SnorbWorks/ender3-pi/PLAN.md

# Ender 3 + Pi — Plan

> **2026-11-09:** the web UI (Ender Studio, `studio/`) moved to its own repo and is now
> **SnorbStudio**, https://github.com/SnorbWorks/snorbstudio (the Design tab is now **SnorbCAD**).
> Paths like `studio/...` below refer to that repo (minus the `studio/` prefix).

Started 2026-10-27. A Raspberry Pi 4 (1 GB, `raspberrypi-1`, 10.0.0.139) runs the
printer over USB with Klipper, and a web UI of our own controls it over Wi-Fi.

## What we have

| | |
|---|---|
| Printer | Reports "Ender-3 E", Creality Marlin 2.0.8.2 (Sep 2022) |
| Link | CH340 USB serial → `/dev/ttyUSB0` on the Pi, 115200 baud |
| Probe | ABL probe (CR Touch style), offset X-43 Y-10, 4×4 mesh |
| Extruder | 93 steps/mm (Creality metal extruder, as on the Neo line) |
| Bed | Mesh spread ≈ 0.46 mm (-0.19 → +0.27): low front left, high at the back |
| Stock tuning | Accel 500, jerk 6, hotend PID 12.53/0.68/47.63, bed PID 198.96/38.80/680.25 |
| Backup | `backup/marlin-M503-2026-10-27.txt`, `backup/marlin-M115-2026-10-27.txt` |

| Mainboard | Creality **V4.2.2**, chip **STM32F103 RCT6** (genuine ST; photo 2026-10-27) |

Klipper build for it (`firmware/klipper-20261027.config`): STM32F103, 28 KiB
bootloader (0x8007000), 8 MHz crystal, serial on USART1 (PA10/PA9) at 250000.

## The firmware answer

Klipper splits the work: the Pi does the thinking (motion planning, macros,
input shaping) and the printer's board only runs a small Klipper program that
moves motors and reads sensors. So **yes, the printer's Marlin gets replaced**
with Klipper's MCU firmware, flashed from the SD card. It's reversible: the
stock Creality `.bin` can be flashed back the same way, and the backup above
has its settings.

## Phases

### 1. Ground work (the Pi)
- Update the OS, set a fixed address (DHCP reservation or `raspberrypi-1.local`).
- Install Klipper + Moonraker (Moonraker is the API our UI talks to).
- Install **Mainsail** too, as a known-good reference/fallback while our UI grows.
- Keep it light for 1 GB: no slicing or building on the Pi; the UI is built on
  the Mac and served as static files by nginx.

### 2. Klipper on the printer
- Identify the board/chip (above), build the matching Klipper firmware.
- Download and keep Creality's stock firmware for this model (way back).
- Flash from the SD card; confirm Klipper connects over `/dev/serial/by-id/…`.
- Write `printer.cfg` from Klipper's sample for the board, with the probe
  offset, `safe_z_home`, bed mesh, runout sensor and thermal protection.

### 3. Calibrate (first prints)
Order matters; each builds on the last.
1. Endstops, motor directions, probe accuracy (`PROBE_ACCURACY`), Z offset.
2. PID for hotend and bed (`PID_CALIBRATE`).
3. Extruder rotation distance (100 mm extrude test).
4. Bed mesh (e.g. 7×7, adaptive meshing per print).
5. Flow / extrusion multiplier, first layer.
6. Pressure advance (tower).
7. **Input shaper** (needs an ADXL345 accelerometer, ~$10): the biggest
   quality-at-speed jump Klipper offers; then raise accel/speed.
8. Retraction, max volumetric flow, skew correction.

### 4. Our web UI (the big one)
Runs in any browser on the network; talks to Moonraker's WebSocket API.
- **Dashboard:** state, temps with graph, progress/ETA, live toolhead position,
  current layer, fan/speed/flow sliders, pause/resume/cancel, emergency stop.
- **Files:** upload G-code (drag & drop), thumbnails, metadata (time, filament),
  print history, start/queue.
- **Modify prints:** G-code viewer with layer preview; edits applied on the Pi
  before printing: pause at layer (filament swap), temperature/speed changes
  at a height, swap start/end G-code, cancel single objects mid-print
  (Klipper `exclude_object`).
- **Control:** jog/home, bed mesh view (3D heatmap), macros as buttons,
  calibration wizards (PID, pressure advance, input shaper) with guided steps.
- **Monitoring:** webcam, timelapse, notifications when a print ends or fails.
- Later: slicing from STL (a slicer CLI, likely on the Mac/another machine,
  not the 1 GB Pi).

### 5. Hardware upgrades (pick as we go)
By payoff for print quality:
1. ADXL345 accelerometer (input shaping) — needed in phase 3.
2. USB webcam (monitoring, timelapse).
3. PEI spring-steel sheet (adhesion, easy removal) if not fitted.
4. Belt tension check, eccentric nuts, silicone bed spacers (holds level).
5. Later: better hotend / direct-drive, part-cooling fan duct.

## Safety rules
- Never open the USB serial port mid-print (it resets the board).
- Keep Klipper's heater checks on; watch the first prints in person.
- Flashing is done by the owner with the printer powered and attended.

## Status
- 2026-10-27 phase 1 done: OS updated; Klipper v0.13.0-818, Moonraker v0.11.0,
  Mainsail v2.19.0 behind nginx at http://raspberrypi-1.local. `printer.cfg` is a
  placeholder (no [mcu]) until the board is flashed.
- Klipper firmware built: `firmware/klipper-20261027.bin`.

- 2026-10-28/29: board flashed, Klipper running the original Ender 3 (blue 12864
  screen). Probe lowered, Z coupler tightened (fixed the height loss), PID + bed
  mesh saved, z_offset 2.950 from first-layer prints. z_guard extra added.
  Ender Studio (our web UI) on port 80, Mainsail on 8080.
- 2026-11-05: filament presets (PLA, PLA+, Silk, PETG, TPU, ABS/ASA) with
  per-filament first-layer squish; temperature tower follows the filament.
  Repo public at https://github.com/SnorbWorks/ender3-pi. Ender Studio now
  updates itself from it (studio/server/updater.py + studio/deploy/install.sh).
  None of the 2026-11-05 work is on the Pi yet (it was off).

- 2026-11-05 evening: Pi switched to the git install (~/ender3-pi, ~/studio ->
  checkout, old copy kept as ~/studio.old-20261105-192607). New macros load
  with no config errors. Two pushed updates installed end to end via push.sh
  (84aaecf, 0f67a59). Printer USB was unplugged/off at the time, so nothing
  printer-side (squish macros in a real print) is tested yet.

## Design tab (Ortho CAD), started 2026-11-09
The owner's spec: `studio/design/SPEC.md`. CAD by drawing in orthographic drafting
views (third-angle), one shared feature list, STL straight to Prepare.

- Source: `studio/design/src` (TypeScript). Build on the Mac with
  `cd studio/design && npm install && npm test` (`npm test` builds too); the output in
  `studio/web/design/` IS committed (the Pi never builds). `replicad_single.wasm` (22 MB,
  OpenCASCADE) only changes when replicad is upgraded.
- All geometry runs in the browser (a worker): the Pi only serves files.
  The tab loads on first visit, so Prepare etc. never pay for the engine.
- Model: stock block + ordered features {rect|circle, view drawn in, centre/size in
  that view's u/v, d0 (face) / d1 (end) as depth toward that view's viewer, add|cut,
  through}. Hidden lines come from OpenCASCADE HLR per view; a visible line wins over a
  hidden one in the same place (`subtractCovered`), duplicates dropped (`dedupe`).
- Choices the owner made: Design tab next to Prepare; Mac mouse/trackpad only; gear tool
  takes module or DP, 14.5/20/25 deg, bore none/round/D-shaft + set screw; checkpoint
  after build-order steps 1-3.
- Projects autosave in the browser (localStorage) and Save/Open (⌘S) keeps them on the Pi:
  `/studio-api/designs/<name>.json` -> `~/printer_data/design/`.
- 2026-11-09 owner feedback round 1 (done): tools in a left toolbox with tool cursors;
  multi-select (shift-click, drag a box); the bar above follows the selection (align
  left/centre/right/top/middle/bottom to each other or to the part, distribute, delete);
  alignment uses the active view (last clicked, label highlighted); ghost views are small
  rounded boxes and empty rows/columns shrink; Option-click a rectangle side,
  Option-Shift-click the side next to it = their corner, with its own radius
  (Feature.corners). Rounds 2-3: body selectable, bigger views, zoom tool, panel splitter.
- Steps 4-7 + the rest of the spec's tools (done 2026-11-09): polygon (P), line/outline (L),
  gear (G: spur/helical/ring/rack, module or DP, 14.5/20/25, backlash, bore none/round/D,
  set screw, hub; a new gear offers to mesh with one already there), text (T, DejaVu fonts),
  hidden-line toggle (H: new shapes go on the far face as pockets, `Feature.far`), edge
  tool (E: pick edges in any view, fillet/chamfer = a 'fillet' feature that remembers each
  edge by a point on it), dimensions (D; double-click the number to type a size), pattern
  (row/circle) and mirror per shape in the panel, body on/off (`stock.off`, for loose
  gears), a features list. Gear flanks are 2 least-squares Béziers each (within 0.5% of
  the module of the true involute) to keep edge counts and HLR time down.
- Round 4 (2026-11-09): fillets follow their edges (`FilletSpec.refs`: the shape whose box
  the edge sits on + where in it, re-found after every build; an edge that's really gone
  shows red with Re-pick); views grow to fit their dimensions (layout margins); projection
  lines for the selection + hidden lines toggle in a Views tab; Send to Library (STL + the
  design saved under the same name); Library "Send to Design" / Open… opens that saved
  design, else the STL as the body (`Project.base`, sewn into a solid in the worker, max
  60k triangles; ~5 s a change on the Pi tray STL since curves are facets).
  `studio/design/tools/pi5_case_design.mjs` turns models/pi5_case.py into Design projects
  (models/pi5_case_*.design.json, uploaded to the Pi as designs pi5_case_tray/_lid).
- Known limits: helical gears take a few seconds to build; an STL body's own walls can't
  be resized (no shapes in an STL); Studio's New still uses a browser confirm().

Build order (spec): 1-7 all DONE. Still open from the spec: print-orientation override in
the tool (Prepare's auto-orient is used now), shell (spec says later).

## Next
1. Owner: connect/switch on the printer, fit the Capricorn tube, re-check the
   Z offset, PETG temperature tower, then a first PETG print (tune squish
   live, "Save for this filament").
2. Watch the first real PRINT_START with MATERIAL=petg: offset applied,
   _STUDIO_FILAMENT set, PRINT_END/cancel clears it.

## Publishing updates
Commit on the Mac, then `sh studio/deploy/push.sh`: pushes to GitHub and, if
the Pi is on, asks it to install now. Otherwise the Pi checks once per
start-up (after the services have stayed up for a minute) and installs when idle (not printing, heaters off,
not slicing). If Ender Studio or Klipper doesn't come back after an update,
install.sh rolls back to the previous commit and won't retry that commit on
its own. Firmware (`firmware/`) and `config/printer.cfg` are NOT pushed by
updates: printer.cfg on the Pi is the live copy (SAVE_CONFIG writes it).
