SnorbWorks/ender3-pi/models/pi5_tray_and_gears.stl

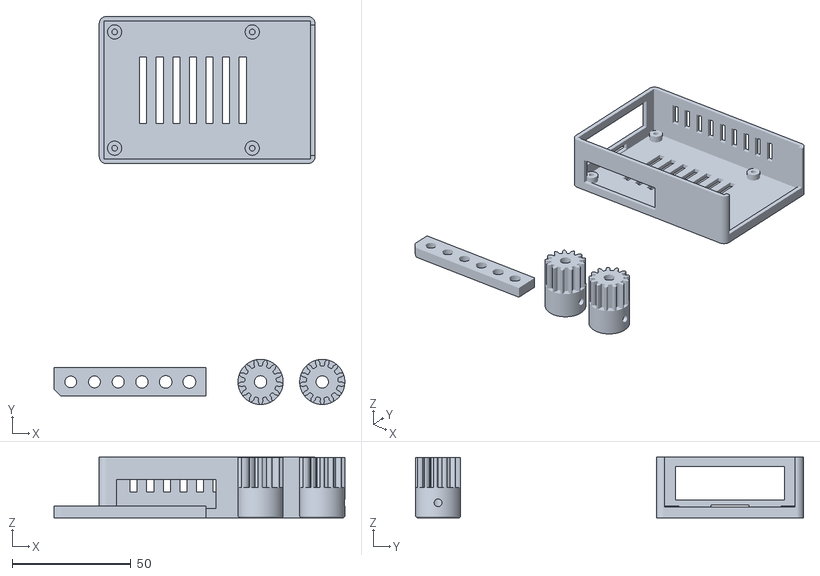
[picture p1: CAD file, 2026-11-06, last stored version]
models/pi5_tray_and_gears.stl
122.5 x 163.5 x 25.6
