SnorbWorks/ender3-pi/models/bore_test.stl

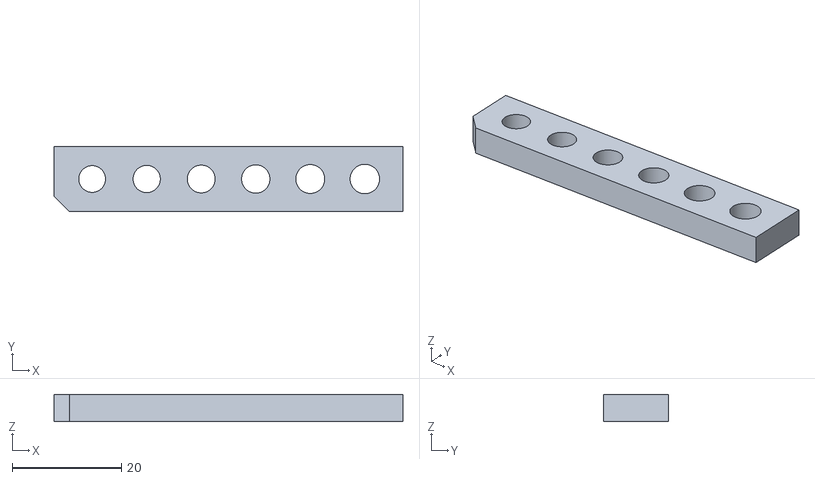
[picture p2: CAD file, 2026-11-06, last stored version]
models/bore_test.stl
64.0 x 12.0 x 5.00
