SnorbWorks/ender3-pi/models/pinion13_20dp_pa14.5.stl

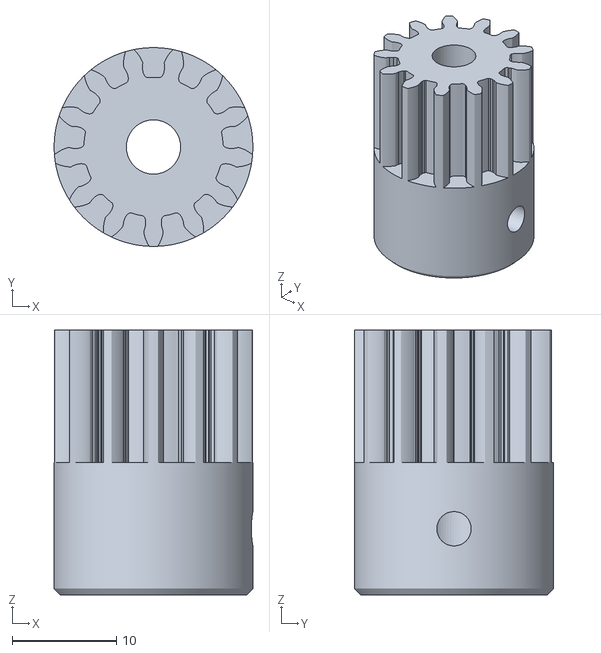
[picture p4: CAD file, 2026-11-06, last stored version]
models/pinion13_20dp_pa14.5.stl
19.1 x 19.1 x 25.4
