SnorbWorks/ender3-pi/models/pi5_case_tray.stl

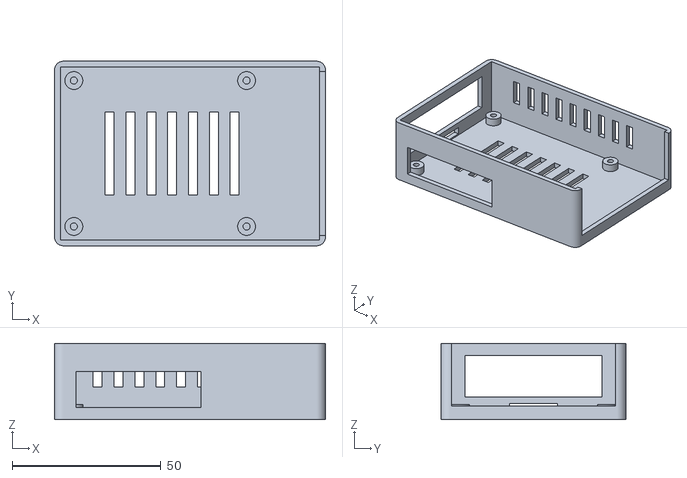
[picture p5: CAD file, 2026-10-30, last stored version]
models/pi5_case_tray.stl
91.0 x 62.0 x 25.6
