SnorbWorks/ender3-pi/models/pi5_case_lid.stl

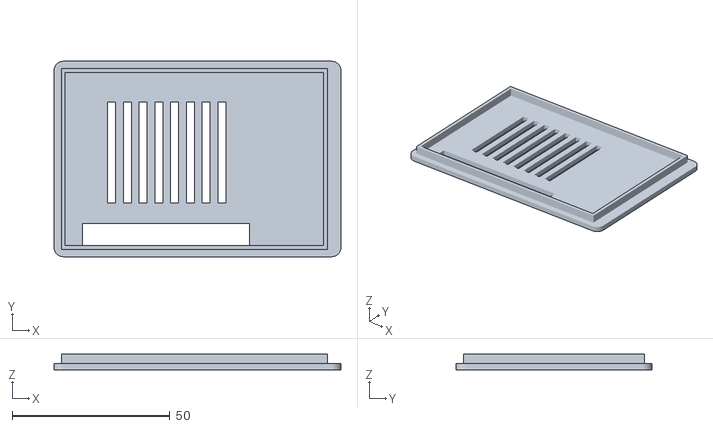
[picture p6: CAD file, 2026-10-30, last stored version]
models/pi5_case_lid.stl
91.0 x 62.0 x 5.00
