SnorbWorks/ender3-pi/config/printer.cfg

# Ender 3 (Creality V4.2.2, STM32F103) on raspberrypi-1.
# Based on Klipper config/printer-creality-ender3-v2-neo-2022.cfg; probe offset
# and extruder steps from the stock Marlin (~/Desktop/ender3-pi/backup).
# Firmware build: ~/Desktop/ender3-pi/firmware/klipper-20261027.config

[include mainsail.cfg]
[include studio_macros.cfg]

[exclude_object]

[gcode_arcs]
resolution: 0.1

# Read-only until its polarity is checked (QUERY_FILAMENT_SENSOR with and
# without filament); then pause_on_runout goes on.
[filament_switch_sensor filament]
switch_pin: ^!PA4  # inverted: read "present" with no filament (2026-10-27)
pause_on_runout: False


[stepper_x]
step_pin: PC2
dir_pin: PB9
enable_pin: !PC3
microsteps: 16
rotation_distance: 40
endstop_pin: ^PA5
position_endstop: 0
position_max: 235
homing_speed: 80

[stepper_y]
step_pin: PB8
dir_pin: PB7
enable_pin: !PC3
microsteps: 16
rotation_distance: 40
endstop_pin: ^PA6
position_endstop: 0
position_max: 235
homing_speed: 80

[stepper_z]
step_pin: PB6
dir_pin: !PB5
enable_pin: !PC3
microsteps: 16
rotation_distance: 8
endstop_pin: probe:z_virtual_endstop
position_max: 250
position_min: -3
homing_speed: 4
second_homing_speed: 1
homing_retract_dist: 2.0

[extruder]
max_extrude_only_distance: 100.0
step_pin: PB4
dir_pin: PB3
enable_pin: !PC3
microsteps: 16
rotation_distance: 34.409  # 200*16/93, from Marlin E-steps 93
nozzle_diameter: 0.400
filament_diameter: 1.750
heater_pin: PA1
sensor_type: EPCOS 100K B57560G104F
sensor_pin: PC5
#control: pid
# tuned for stock hardware with 200 degree Celsius target
#pid_Kp: 21.527
#pid_Ki: 1.063
#pid_Kd: 108.982
min_temp: 0
max_temp: 250

[heater_bed]
heater_pin: PA2
sensor_type: EPCOS 100K B57560G104F
sensor_pin: PC4
#control: pid
# tuned for stock hardware with 70 degree Celsius target
#pid_kp: 70.405
#pid_ki: 1.229
#pid_kd: 1008.553
min_temp: 0
max_temp: 130

[fan]
pin: PA0

[mcu]
serial: /dev/serial/by-id/usb-1a86_USB_Serial-if00-port0
restart_method: command

[printer]
kinematics: cartesian
max_velocity: 300
max_accel: 5000
max_z_velocity: 5
square_corner_velocity: 5.0
max_z_accel: 100

[bltouch]
sensor_pin: ^PB1
control_pin: PB0
x_offset: -43.0  # from Marlin M851
y_offset: -10.0
#z_offset: 0
speed: 20
samples: 1
sample_retract_dist: 8.0
probe_with_touch_mode: True
stow_on_each_sample: True
pin_up_touch_mode_reports_triggered: True

[safe_z_home]
home_xy_position: 160,120
speed: 150
z_hop: 10
z_hop_speed: 10

[bed_mesh]
speed: 120
mesh_min: 30,30         # Need to handle head distance with cr-touch (bl_touch)
mesh_max: 189,189       # Max probe range
probe_count: 5,5
fade_start: 1
fade_end: 10
fade_target: 0
algorithm: bicubic

[bed_screws]
screw1:30,25
screw1_name:1
screw2:200,25
screw2_name:2
screw3:200,195
screw3_name:3
screw4:30,195
screw4_name:4

[screws_tilt_adjust]
screw1: 67, 42
screw1_name: front left screw
screw2: 237.60, 42
screw2_name: front right screw
screw3: 237.60, 212
screw3_name: rear right screw
screw4: 67.60, 212
screw4_name: rear left screw
horizontal_move_z: 10
speed: 200
screw_thread: CW-M4 # Use CW for Clockwise and CCW for Counter Clockwise

# Original Ender 3 blue 12864 screen with knob (EXP3 ribbon on the V4.2.2).
# The Neo profile's beeper on PB13 is gone: that pin is the screen's clock.
[display]
lcd_type: st7920
cs_pin: PB12
sclk_pin: PB13
sid_pin: PB15
encoder_pins: ^PB14, ^PB10
click_pin: ^!PB2

# Z crash guard (TEST MODE): the Z limit switch on the left upright (board
# socket Z, PA7). Klipper only reads end switches while homing; this watches
# it all the time. For now it only reports; once the switch is set just below
# printing height, press_gcode becomes M112 (emergency stop).
[z_guard]
pin: ^PA7
mode: homing

# Manual moves without homing (SET_KINEMATIC_POSITION, FORCE_MOVE), for
# careful testing while Z homing is not trusted.
[force_move]
enable_force_move: True

#*# <---------------------- SAVE_CONFIG ---------------------->
#*# DO NOT EDIT THIS BLOCK OR BELOW. The contents are auto-generated.
#*#
#*# [bltouch]
#*# z_offset = 2.950
#*#
#*# [extruder]
#*# control = pid
#*# pid_kp = 17.556
#*# pid_ki = 1.361
#*# pid_kd = 56.619
#*#
#*# [heater_bed]
#*# control = pid
#*# pid_kp = 63.269
#*# pid_ki = 2.078
#*# pid_kd = 481.633
#*#
#*# [bed_mesh default]
#*# version = 1
#*# points =
#*# 	-0.172500, -0.170000, -0.142500, -0.120000, -0.135000
#*# 	-0.105000, -0.075000, -0.030000, -0.030000, -0.042500
#*# 	-0.095000, -0.057500, 0.005000, -0.005000, -0.030000
#*# 	-0.140000, -0.072500, -0.007500, -0.017500, -0.035000
#*# 	-0.197500, -0.160000, -0.137500, -0.125000, -0.140000
#*# x_count = 5
#*# y_count = 5
#*# mesh_x_pps = 2
#*# mesh_y_pps = 2
#*# algo = bicubic
#*# tension = 0.2
#*# min_x = 30.0
#*# max_x = 189.0
#*# min_y = 30.0
#*# max_y = 189.0
