SnorbWorks/ender3-pi/(commit log)

2026-10-28 Ender 3 + Pi: plan, Marlin backup, Klipper firmware for the V4.2.2 board
2026-10-28 Klipper running on the board: printer.cfg + moonraker.conf
    [printer.cfg]
2026-10-29 CR Touch: touch mode, position_min -3, z_offset 2.000; Z switch guard + force_move
    Probe was mounted too high (pin level with nozzle) and its short trigger
    pulse was missed; probe lowered ~3/16in, touch mode enabled.
    [printer.cfg]
2026-10-29 z_guard: Z switch shuts the printer down if pressed while homing/probing
    [printer.cfg]
2026-10-29 PID tuned: hotend 200C, bed 60C
    [printer.cfg]
2026-10-29 Bed levelled (1.14 -> 0.28 mm) and default mesh saved
    [printer.cfg]
2026-10-29 Bed re-levelled to 0.20 mm spread; mesh saved
    [printer.cfg]
2026-10-29 Ender Studio: web UI + slicing helper for the Pi
    Prepare (3D plate: lay flat, pick face, auto-orient, overhang map,
    arrange, copies, mirror, advanced settings, PrusaSlicer slicing,
    layer preview with colour changes), Print (progress, live Z, speed/flow/
    fan, skip objects, pause at layer, queue, temperature chart), Control
    (jog, heat, filament, macros, console), Files (thumbnails, history,
    model library), Maintenance (status, Z guard, bed map + levelling
    assistant, Z offset/PID/extruder calibration, calibration prints,
    config editor, logs, power).
    [studio_macros.cfg]
2026-10-29 Ender Studio: add shapes (box, cylinder, tube, cone, sphere, text label)
2026-10-30 Z offset 2.950 from first-layer test prints
    [printer.cfg]
2026-10-30 Enable the original Ender 3 12864 screen (st7920); drop Neo beeper on PB13
    [printer.cfg]
2026-10-30 Pi 5 case (tray + vented lid), generated with manifold3d
    [pi5_case_lid.stl, pi5_case_tray.stl]
2026-11-05 Ender Studio: filament presets with per-filament first-layer squish
    Six filaments (PLA, PLA+, Silk PLA, PETG, TPU, ABS/ASA) set temps, fan,
    retraction, speed and max flow. PRINT_START applies the filament's squish
    (SET_GCODE_OFFSET, PLA = reference) and PRINT_END/cancel clear it. The
    Print page saves live Z tweaks into that filament's squish (SAVE_VARIABLE,
    works mid-print); Maintenance lists them. Control preheat uses the same list.
    [studio_macros.cfg]
2026-11-05 Temperature tower follows the chosen filament (PETG 250 -> 230 C)
2026-11-05 Ender Studio updates itself from GitHub
    The Pi keeps a git checkout (~/studio links into it). updater.py fetches
    every 6 h (and 2 min after boot) and, when the printer is idle (not printing,
    heaters off, not slicing), fast-forwards and runs install.sh in its own
    systemd unit. install.sh only copies/restarts what changed, checks Ender
    Studio and Klipper come back, and otherwise rolls back to the previous commit
    (and won't retry that commit by itself). Maintenance page: Software updates
    card (Check now, Install now, auto toggle), dot on the tab when one is ready.
    push.sh now pushes to GitHub and asks the Pi to install right away.
2026-11-06 Updater: check once per start-up, after the printer services settle
    No more 6-hourly checks. After Ender Studio starts it waits until klipper,
    moonraker, nginx and ender-studio have all been active (and Klipper past
    'startup') for 60 s - or 15 min at most - then fetches once, retrying a
    failed fetch for up to ~10 min in case Wi-Fi is late. Check now and push.sh
    still check on demand.
2026-11-06 Control: Load/Unload use the picked filament's temperature, not a leftover target
    Loading PETG right after unloading PLA used 210 C (the unload's target).
2026-11-06 Prepare: the filament fills its Advanced boxes; edits stick to that filament
    Picking a filament now fills nozzle, bed, speed, fan and retraction with its
    preset, visibly. Changing one is remembered for that filament only (orange)
    and only differences from the preset are sent to the slicer. Old saved
    Advanced temperatures etc. are dropped - a leftover PLA 215 C nozzle had
    silently overridden the PETG preset.
2026-11-06 PRINT_START: longer purge (3 lines) and a wipe so the purge string doesn't reach the print
    PETG left a blob and a string at the start of the first part.
    [studio_macros.cfg]
2026-11-06 Lead-in purge: purge right in front of the part and end at its corner
    Ender Studio now slices with PRINT_START AREA=<first layer box>. PRINT_START
    draws three purge passes (thickest furthest out) 10 mm in front of the part,
    or behind it if there's no room, and the last pass ends at the part's
    corner with no retract or lift, so there's no long trip across the bed for
    a PETG string or blob to follow. G-code without AREA keeps the left-edge
    purge (now with a wipe).
    [studio_macros.cfg]
2026-11-06 Jukebox pinion: 13T 20DP spur gear (mates 48T/64 mm), 5 mm bore, 1" long
    0.5" teeth on a plain 0.5" hub. Teeth hob-generated (rack rolled round the
    blank) so the 13-tooth undercut is right; 20 and 14.5 deg pressure angle
    versions. Mesh with a 48T gear checked in 2D: no overlap over a full cycle.
    [pinion13_20dp_pa14.5.stl, pinion13_20dp_pa20.stl]
2026-11-06 Pinion: M3 set screw + nut slot in the hub; bore_test.stl (4.9-5.4 mm holes)
    [bore_test.stl, pinion13_20dp_pa14.5.stl, pinion13_20dp_pa20.stl]
2026-11-06 Plate file: Pi 5 tray + both pinions + bore test, laid out clear of the bed sheet's bad spot
    [pi5_tray_and_gears.stl]
2026-11-07 Slicing at 100% infill: switch to rectilinear when the pattern can't do solid
    PrusaSlicer refuses gyroid (the default), honeycomb, cubic... at 100% with
    "The selected fill pattern is not supposed to work at 100% density".
2026-11-07 Stop tracking print files (STL/3MF/OBJ/G-code)
    They're generated by models/*.py and live in the printer's library; the
    local copies stay on disk.
    [bore_test.stl, pi5_case_lid.stl, pi5_case_tray.stl, pi5_tray_and_gears.stl, pinion13_20dp_pa14.5.stl, pinion13_20dp_pa20.stl]
2026-11-07 PETG preset: wipe on retract + avoid crossing perimeters
    Cuts the ooze that collected on the nozzle and the strings across open gaps
    (a PETG blob pulled the hotend sock off during the Pi 5 lid).
2026-11-10 Design tab: orthographic CAD sheet (spec steps 1-3)
    Draw in drafting views (third-angle, ghost boxes add views), rectangles and
    circles that add or cut, depth by dragging in a side view, selection and
    handles across every view, T-square snapping guides, automatic hidden lines
    (OpenCASCADE HLR via replicad in a web worker), 3D preview, STL straight to
    Prepare with auto-orient. TypeScript in studio/design, built into
    studio/web/design.
2026-11-10 Design tab: steps 4-7 - polygon, line, gears, text, hidden-line tool, fillets, dimensions, pattern/mirror, save/open on the Pi
    Also hides the printer-not-ready banner on the Design tab.
2026-11-10 Design tab: fillets follow their edges (Re-pick when lost), views grow to fit dimensions, projection lines + Views tab, Send to Library, Send to Design / open library STLs, Pi 5 case as Design projec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
2026-11-10 Ender Studio moved to its own repo: SnorbWorks/snorbstudio (now SnorbStudio + SnorbCAD)
    [studio_macros.cfg]
